PurdueROV-Archive/Cerulean-Microboard/readme.MD

This is an example repository of the previous Microboard for the ROV.

The Microboard was the brains of the ROV.
