PurdueROV-Archive/Cerulean-Microboard/MicroBoardMk2/revision.md

# pending

# applied

# not needed

# notes
Pick different buttons, as they dont fits on pads right
Check if BOOT1 needs to be pulled to GND for usb DFU
Make silkscreen larger (at least 0.4)
Remove Diode on 5V line
Figure out how to switch the 5V rail along with the +3V3 Rail
Add standoff holes
Silkscreen on GRN and BLU LED's is switched. (not by the pin but by the actual LED)
