PurdueROV-Archive/Cerulean-Microboard/MicroBoardMk2/MicroBoardMk2.png

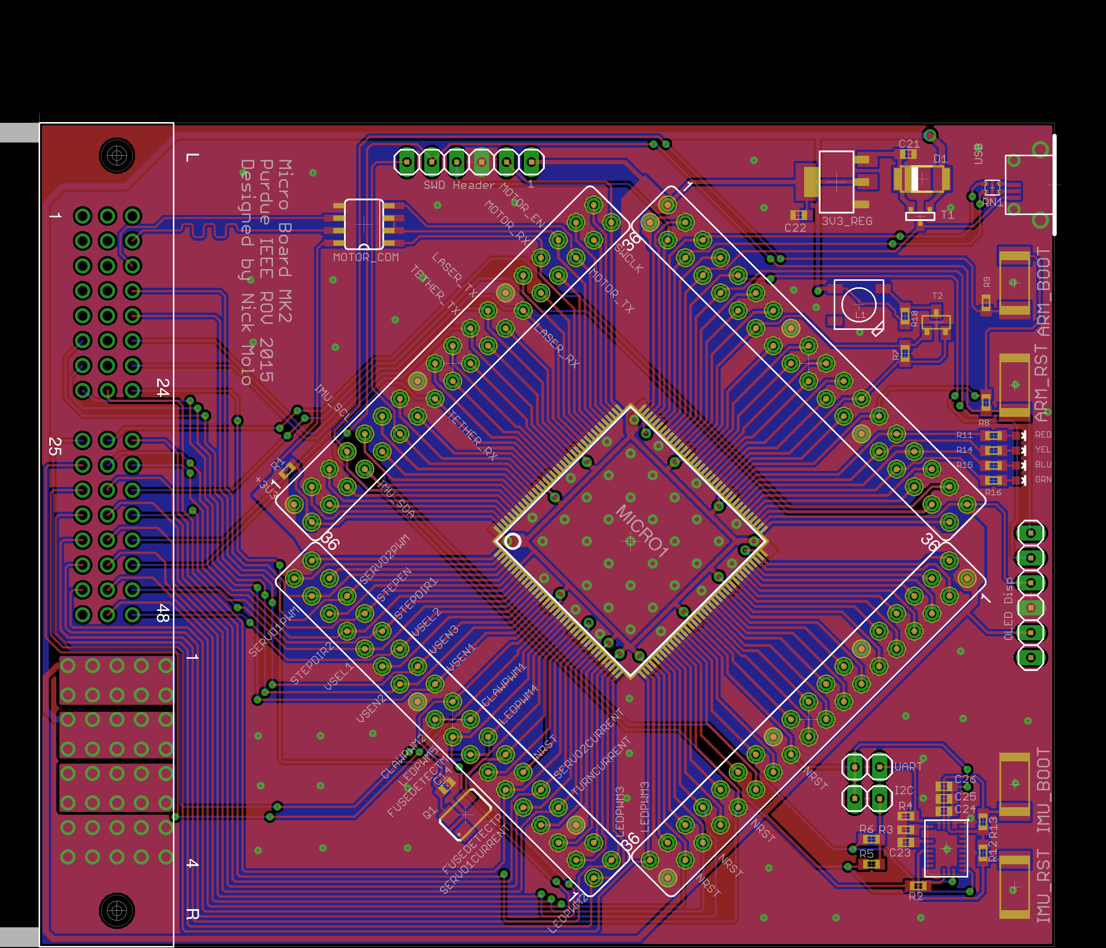
MicroBoardMk2/MicroBoardMk2.png
