PurdueROV-Archive/Cerulean-Microboard/MicroBoardMk1/MicroBoardMk1.brd

## EAGLE design MicroBoardMk1/MicroBoardMk1.brd (2015-09-24, an earlier design)

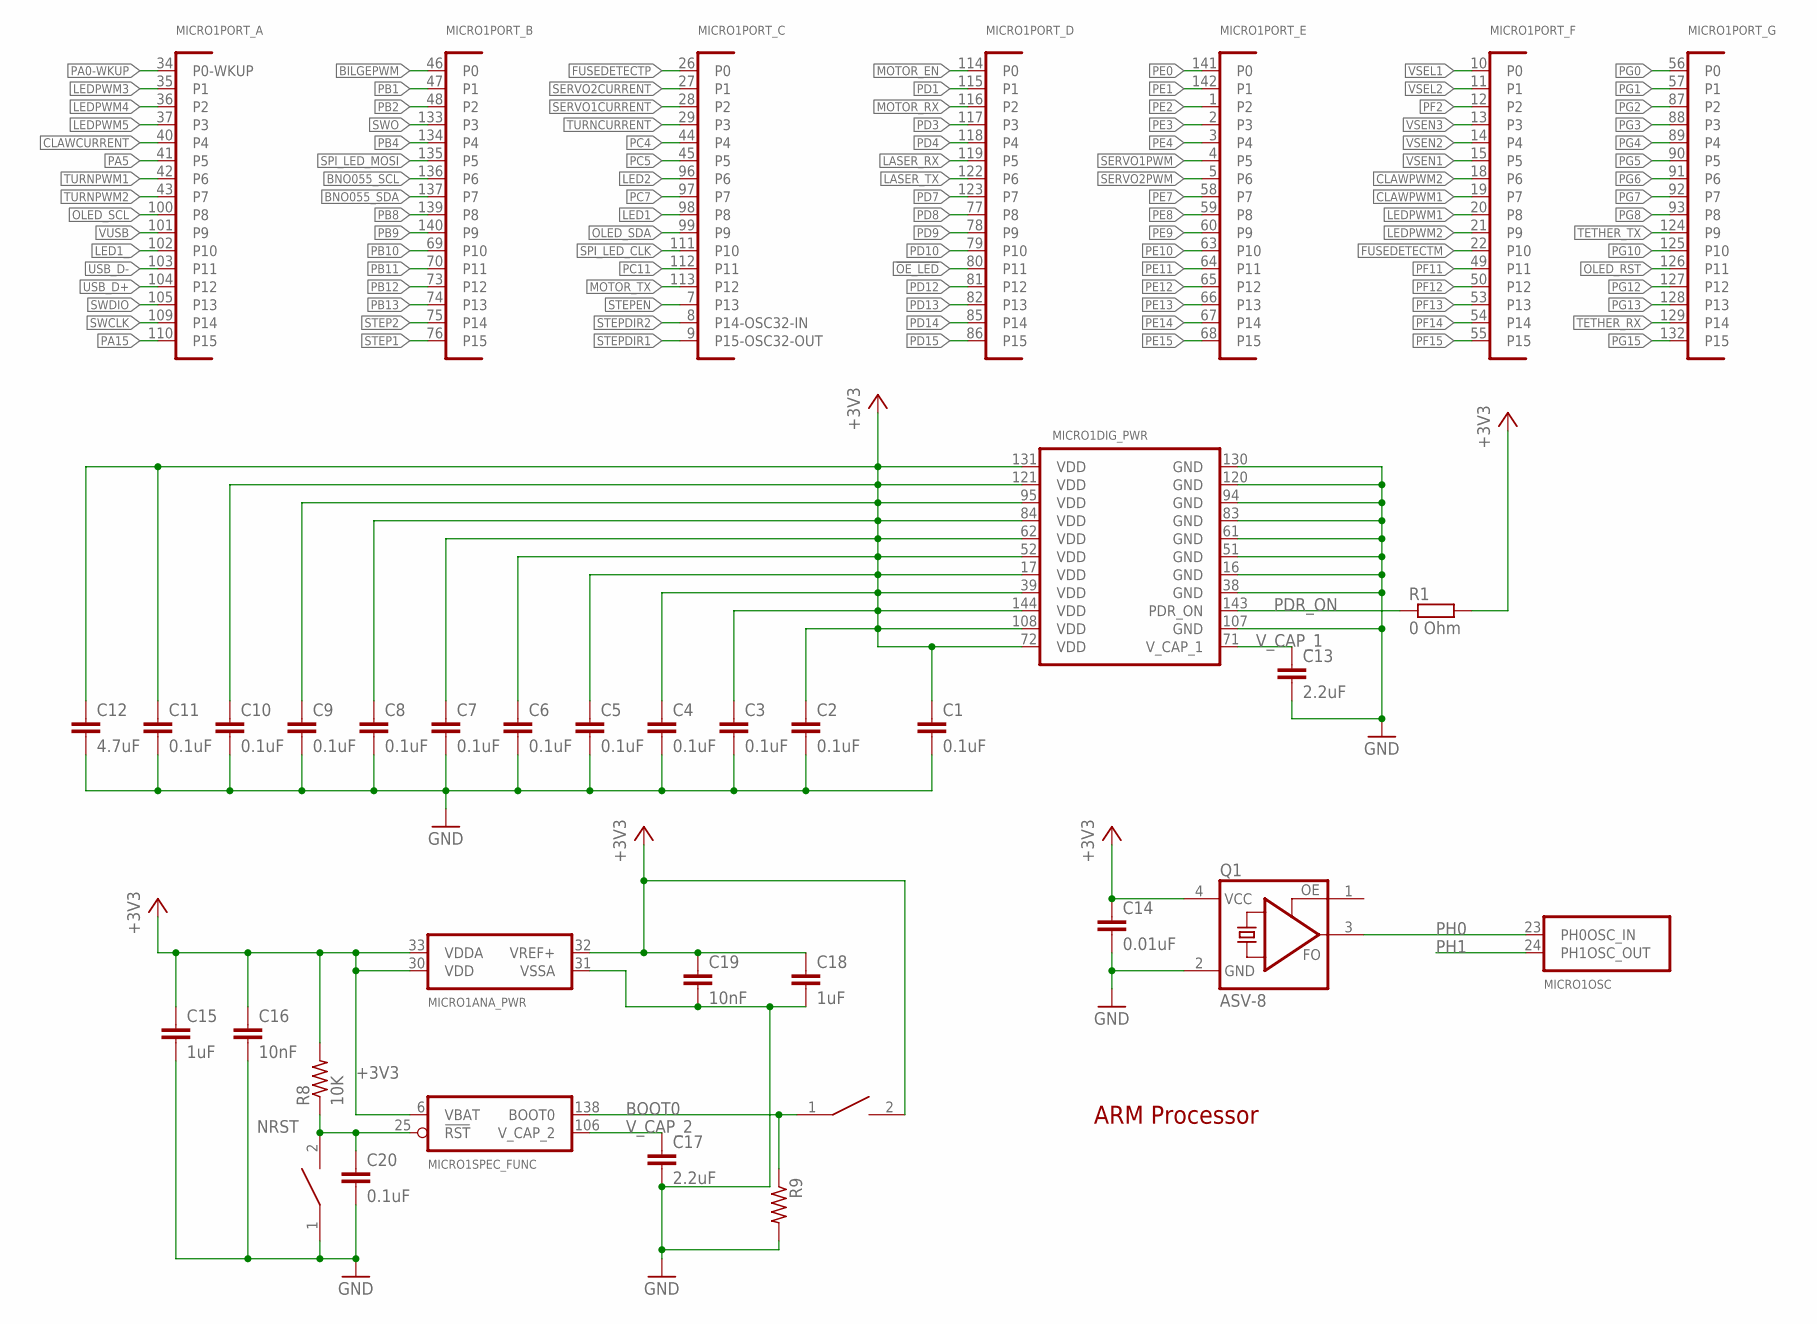
[picture p2: schematic MicroBoardMk1.sch, sheet 1]

Parts:
BOOT_SW: SWITCH; SW_2512
C1, C2, C3, C4, C5, C6, C7, C8, C9, C10, C11, C20: 0.1uF; C0603
C12: 4.7uF; C0603
C13, C17: 2.2uF; C0603
C14: 0.01uF; C0603
C15, C18: 1uF; C0603
C16, C19: 10nF; C0603
MICRO1: STM32F407ZET6; SQFP-S-20X20-144
Q1: ASV-8; ASF
R1: 0 Ohm; R0603
R8: 10K; R0603
R9: R-US_R0603; R0603
RST_SW: SWITCH; SW_2512

Connections:
!OE_LED: MICRO1.80 (P11); also elsewhere on the board
+3V3: BOOT_SW.2, C1.1, C2.1, C3.1, C4.1, C5.1, C6.1, C7.1, C8.1, C9.1, C10.1, C11.1, C12.1, C14.1, C15.1, C16.1, C18.1, C19.1, MICRO1.6 (VBAT), MICRO1.17 (VDD), MICRO1.30 (VDD), MICRO1.32 (VREF+), MICRO1.33 (VDDA), MICRO1.39 (VDD), MICRO1.52 (VDD), MICRO1.62 (VDD), MICRO1.72 (VDD), MICRO1.84 (VDD), MICRO1.95 (VDD), MICRO1.108 (VDD), MICRO1.121 (VDD), MICRO1.131 (VDD), MICRO1.144 (VDD), Q1.4 (VCC), R1.2, R8.2; also elsewhere on the board
BILGEPWM: MICRO1.46 (P0); also elsewhere on the board
BNO055_SCL: MICRO1.136 (P6); also elsewhere on the board
BNO055_SDA: MICRO1.137 (P7); also elsewhere on the board
BOOT0: BOOT_SW.1, MICRO1.138 (BOOT0), R9.1; also elsewhere on the board
CLAWCURRENT: MICRO1.40 (P4); also elsewhere on the board
CLAWPWM1: MICRO1.19 (P7); also elsewhere on the board
CLAWPWM2: MICRO1.18 (P6); also elsewhere on the board
FUSEDETECTM: MICRO1.22 (P10); also elsewhere on the board
FUSEDETECTP: MICRO1.26 (P0); also elsewhere on the board
GND: C1.2, C2.2, C3.2, C4.2, C5.2, C6.2, C7.2, C8.2, C9.2, C10.2, C11.2, C12.2, C13.2, C14.2, C15.2, C16.2, C17.2, C18.2, C19.2, C20.2, MICRO1.16 (GND), MICRO1.31 (VSSA), MICRO1.38 (GND), MICRO1.51 (GND), MICRO1.61 (GND), MICRO1.83 (GND), MICRO1.94 (GND), MICRO1.107 (GND), MICRO1.120 (GND), MICRO1.130 (GND), Q1.2 (GND), R9.2, RST_SW.1; also elsewhere on the board
LASER_RX: MICRO1.119 (P5); also elsewhere on the board
LASER_TX: MICRO1.122 (P6); also elsewhere on the board
LED1: MICRO1.98 (P8); also elsewhere on the board
LED1_: MICRO1.102 (P10); also elsewhere on the board
LED2: MICRO1.96 (P6); also elsewhere on the board
LEDPWM1: MICRO1.20 (P8); also elsewhere on the board
LEDPWM2: MICRO1.21 (P9); also elsewhere on the board
LEDPWM3: MICRO1.35 (P1); also elsewhere on the board
LEDPWM4: MICRO1.36 (P2); also elsewhere on the board
LEDPWM5: MICRO1.37 (P3); also elsewhere on the board
MOTOR_EN: MICRO1.114 (P0); also elsewhere on the board
MOTOR_RX: MICRO1.116 (P2); also elsewhere on the board
MOTOR_TX: MICRO1.113 (P12); also elsewhere on the board
NRST: C20.1, MICRO1.25 (!RST), R8.1, RST_SW.2; also elsewhere on the board
OLED_RST: MICRO1.126 (P11); also elsewhere on the board
OLED_SCL: MICRO1.100 (P8); also elsewhere on the board
OLED_SDA: MICRO1.99 (P9); also elsewhere on the board
PA0-WKUP: MICRO1.34 (P0-WKUP); also elsewhere on the board
PA5: MICRO1.41 (P5); also elsewhere on the board
PA15: MICRO1.110 (P15); also elsewhere on the board
PB1: MICRO1.47 (P1); also elsewhere on the board
PB2: MICRO1.48 (P2); also elsewhere on the board
PB4: MICRO1.134 (P4); also elsewhere on the board
PB8: MICRO1.139 (P8); also elsewhere on the board
PB9: MICRO1.140 (P9); also elsewhere on the board
PB10: MICRO1.69 (P10); also elsewhere on the board
PB11: MICRO1.70 (P11); also elsewhere on the board
PB12: MICRO1.73 (P12); also elsewhere on the board
PB13: MICRO1.74 (P13); also elsewhere on the board
PC4: MICRO1.44 (P4); also elsewhere on the board
PC5: MICRO1.45 (P5); also elsewhere on the board
PC7: MICRO1.97 (P7); also elsewhere on the board
PC11: MICRO1.112 (P11); also elsewhere on the board
PD1: MICRO1.115 (P1); also elsewhere on the board
PD3: MICRO1.117 (P3); also elsewhere on the board
PD4: MICRO1.118 (P4); also elsewhere on the board
PD7: MICRO1.123 (P7); also elsewhere on the board
PD8: MICRO1.77 (P8); also elsewhere on the board
PD9: MICRO1.78 (P9); also elsewhere on the board
PD10: MICRO1.79 (P10); also elsewhere on the board
PD12: MICRO1.81 (P12); also elsewhere on the board
PD13: MICRO1.82 (P13); also elsewhere on the board
PD14: MICRO1.85 (P14); also elsewhere on the board
PD15: MICRO1.86 (P15); also elsewhere on the board
PDR_ON: MICRO1.143 (PDR_ON), R1.1; also elsewhere on the board
PE0: MICRO1.141 (P0); also elsewhere on the board
PE1: MICRO1.142 (P1); also elsewhere on the board
PE2: MICRO1.1 (P2); also elsewhere on the board
PE3: MICRO1.2 (P3); also elsewhere on the board
PE4: MICRO1.3 (P4); also elsewhere on the board
PE7: MICRO1.58 (P7); also elsewhere on the board
PE8: MICRO1.59 (P8); also elsewhere on the board
PE9: MICRO1.60 (P9); also elsewhere on the board
PE10: MICRO1.63 (P10); also elsewhere on the board
PE11: MICRO1.64 (P11); also elsewhere on the board
PE12: MICRO1.65 (P12); also elsewhere on the board
PE13: MICRO1.66 (P13); also elsewhere on the board
PE14: MICRO1.67 (P14); also elsewhere on the board
PE15: MICRO1.68 (P15); also elsewhere on the board
PF2: MICRO1.12 (P2); also elsewhere on the board
PF11: MICRO1.49 (P11); also elsewhere on the board
PF12: MICRO1.50 (P12); also elsewhere on the board
PF13: MICRO1.53 (P13); also elsewhere on the board
PF14: MICRO1.54 (P14); also elsewhere on the board
PF15: MICRO1.55 (P15); also elsewhere on the board
PG0: MICRO1.56 (P0); also elsewhere on the board
PG1: MICRO1.57 (P1); also elsewhere on the board
PG2: MICRO1.87 (P2); also elsewhere on the board
PG3: MICRO1.88 (P3); also elsewhere on the board
PG4: MICRO1.89 (P4); also elsewhere on the board
PG5: MICRO1.90 (P5); also elsewhere on the board
PG6: MICRO1.91 (P6); also elsewhere on the board
PG7: MICRO1.92 (P7); also elsewhere on the board
PG8: MICRO1.93 (P8); also elsewhere on the board
PG10: MICRO1.125 (P10); also elsewhere on the board
PG12: MICRO1.127 (P12); also elsewhere on the board
PG13: MICRO1.128 (P13); also elsewhere on the board
PG15: MICRO1.132 (P15); also elsewhere on the board
PH0: MICRO1.23 (PH0OSC_IN), Q1.3 (FO); also elsewhere on the board
PH1: MICRO1.24 (PH1OSC_OUT); also elsewhere on the board
SERVO1CURRENT: MICRO1.28 (P2); also elsewhere on the board
SERVO1PWM: MICRO1.4 (P5); also elsewhere on the board
SERVO2CURRENT: MICRO1.27 (P1); also elsewhere on the board
SERVO2PWM: MICRO1.5 (P6); also elsewhere on the board
SPI_LED_CLK: MICRO1.111 (P10); also elsewhere on the board
SPI_LED_MOSI: MICRO1.135 (P5); also elsewhere on the board
STEP1: MICRO1.76 (P15); also elsewhere on the board
STEP2: MICRO1.75 (P14); also elsewhere on the board
STEPDIR1: MICRO1.9 (P15-OSC32-OUT); also elsewhere on the board
STEPDIR2: MICRO1.8 (P14-OSC32-IN); also elsewhere on the board
STEPEN: MICRO1.7 (P13); also elsewhere on the board
SWCLK: MICRO1.109 (P14); also elsewhere on the board
SWDIO: MICRO1.105 (P13); also elsewhere on the board
SWO: MICRO1.133 (P3); also elsewhere on the board
TETHER_RX: MICRO1.129 (P14); also elsewhere on the board
TETHER_TX: MICRO1.124 (P9); also elsewhere on the board
TURNCURRENT: MICRO1.29 (P3); also elsewhere on the board
TURNPWM1: MICRO1.42 (P6); also elsewhere on the board
TURNPWM2: MICRO1.43 (P7); also elsewhere on the board
USB_D+: MICRO1.104 (P12); also elsewhere on the board
USB_D-: MICRO1.103 (P11); also elsewhere on the board
VSEL1: MICRO1.10 (P0); also elsewhere on the board
VSEL2: MICRO1.11 (P1); also elsewhere on the board
VSEN1: MICRO1.15 (P5); also elsewhere on the board
VSEN2: MICRO1.14 (P4); also elsewhere on the board
VSEN3: MICRO1.13 (P3); also elsewhere on the board
VUSB: MICRO1.101 (P9); also elsewhere on the board
V_CAP_1: C13.1, MICRO1.71 (V_CAP_1); also elsewhere on the board
V_CAP_2: C17.1, MICRO1.106 (V_CAP_2); also elsewhere on the board

Notes on the sheet:
ARM Processor

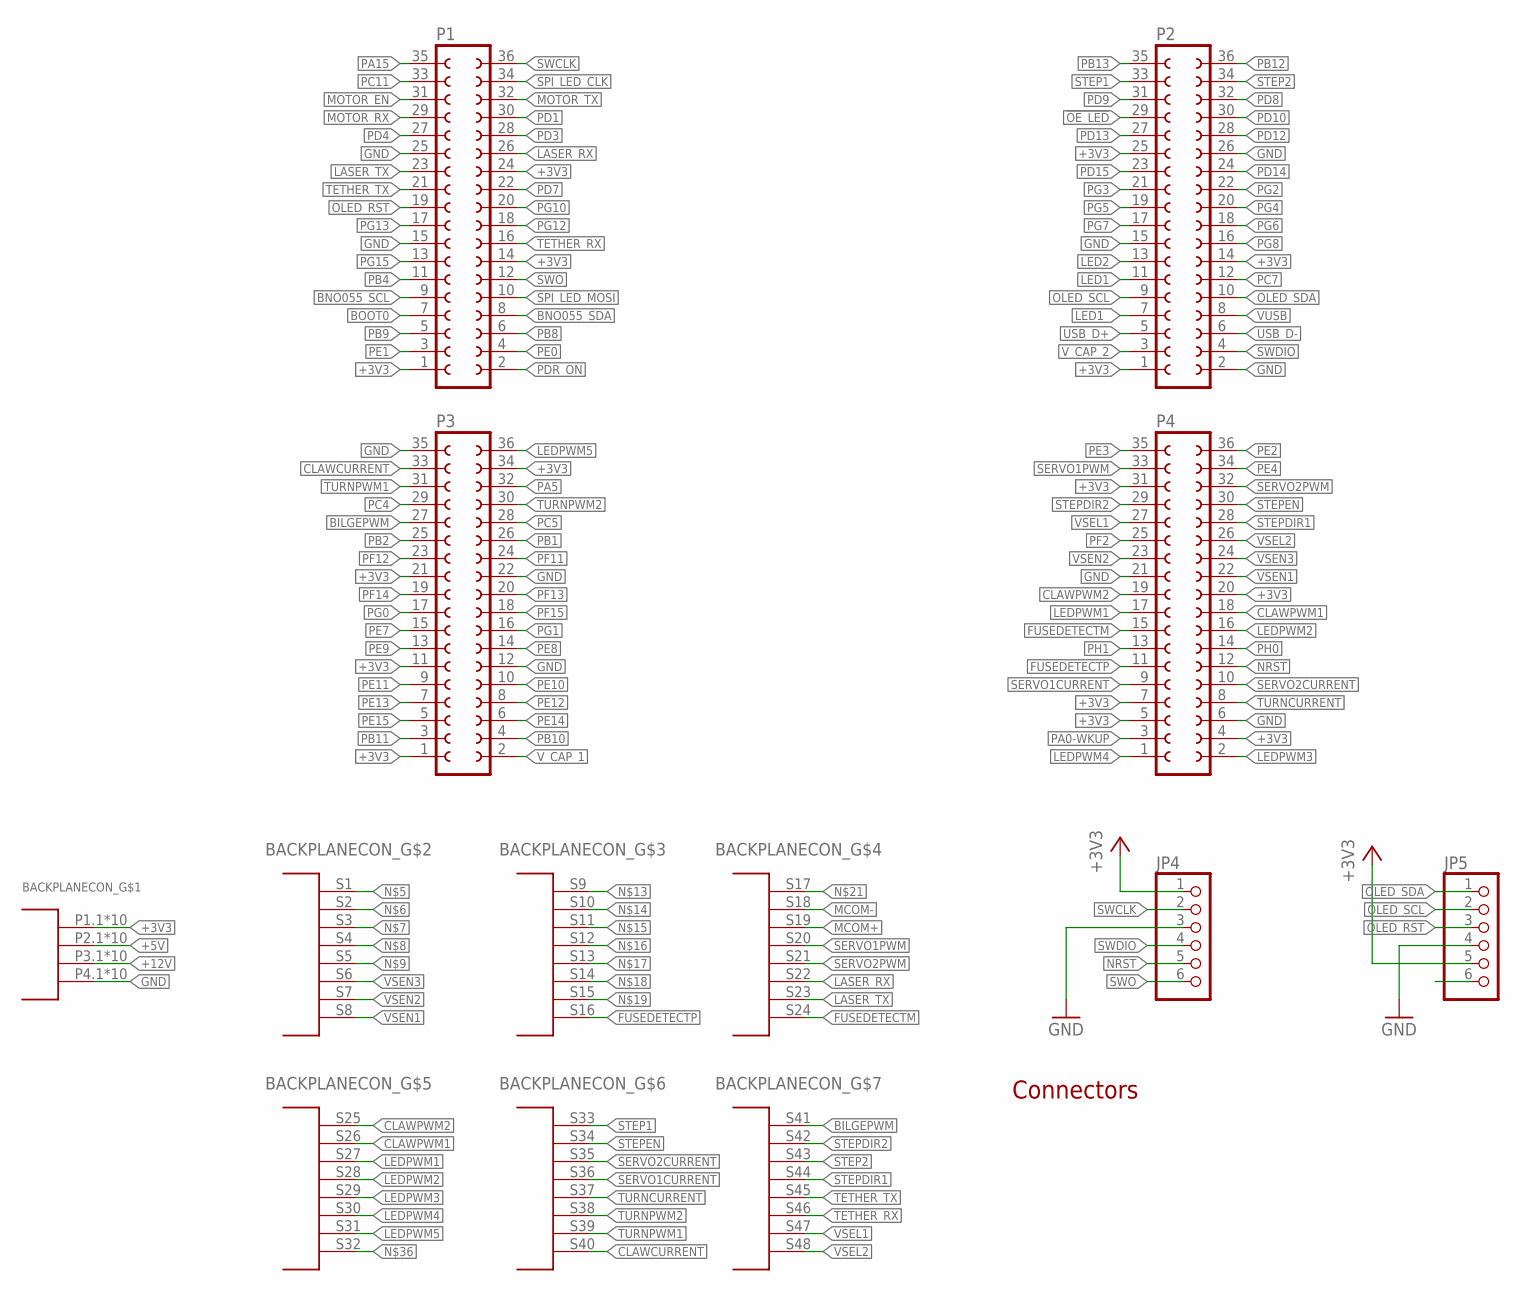
[picture p3: schematic MicroBoardMk1.sch, sheet 2]

Parts:
BACKPLANECON_: TEN60-S24-S24-P4-RA
JP4, JP5: PINHD-1X6; 1X06
P1, P2, P3, P4: FE18-2

Connections:
!OE_LED: P2.29; also elsewhere on the board
+3V3: BACKPLANECON_.P1.1, BACKPLANECON_.P1.2, BACKPLANECON_.P1.3, BACKPLANECON_.P1.4, BACKPLANECON_.P1.5, BACKPLANECON_.P1.6, BACKPLANECON_.P1.7, BACKPLANECON_.P1.8, BACKPLANECON_.P1.9, BACKPLANECON_.P1.10, JP4.1, JP5.5, P1.1, P1.14, P1.24, P2.1, P2.14, P2.25, P3.1, P3.11, P3.21, P3.34, P4.4, P4.5, P4.7, P4.20, P4.31; also elsewhere on the board
+5V: BACKPLANECON_.P2.1, BACKPLANECON_.P2.2, BACKPLANECON_.P2.3, BACKPLANECON_.P2.4, BACKPLANECON_.P2.5, BACKPLANECON_.P2.6, BACKPLANECON_.P2.7, BACKPLANECON_.P2.8, BACKPLANECON_.P2.9, BACKPLANECON_.P2.10; also elsewhere on the board
+12V: BACKPLANECON_.P3.1, BACKPLANECON_.P3.2, BACKPLANECON_.P3.3, BACKPLANECON_.P3.4, BACKPLANECON_.P3.5, BACKPLANECON_.P3.6, BACKPLANECON_.P3.7, BACKPLANECON_.P3.8, BACKPLANECON_.P3.9, BACKPLANECON_.P3.10
BILGEPWM: BACKPLANECON_.S41, P3.27; also elsewhere on the board
BNO055_SCL: P1.9; also elsewhere on the board
BNO055_SDA: P1.8; also elsewhere on the board
BOOT0: P1.7; also elsewhere on the board
CLAWCURRENT: BACKPLANECON_.S40, P3.33; also elsewhere on the board
CLAWPWM1: BACKPLANECON_.S26, P4.18; also elsewhere on the board
CLAWPWM2: BACKPLANECON_.S25, P4.19; also elsewhere on the board
FUSEDETECTM: BACKPLANECON_.S24, P4.15; also elsewhere on the board
FUSEDETECTP: BACKPLANECON_.S16, P4.11; also elsewhere on the board
GND: BACKPLANECON_.P4.1, BACKPLANECON_.P4.2, BACKPLANECON_.P4.3, BACKPLANECON_.P4.4, BACKPLANECON_.P4.5, BACKPLANECON_.P4.6, BACKPLANECON_.P4.7, BACKPLANECON_.P4.8, BACKPLANECON_.P4.9, BACKPLANECON_.P4.10, JP4.3, JP5.4, P1.15, P1.25, P2.2, P2.15, P2.26, P3.12, P3.22, P3.35, P4.6, P4.21; also elsewhere on the board
LASER_RX: BACKPLANECON_.S22, P1.26; also elsewhere on the board
LASER_TX: BACKPLANECON_.S23, P1.23; also elsewhere on the board
LED1: P2.11; also elsewhere on the board
LED1_: P2.7; also elsewhere on the board
LED2: P2.13; also elsewhere on the board
LEDPWM1: BACKPLANECON_.S27, P4.17; also elsewhere on the board
LEDPWM2: BACKPLANECON_.S28, P4.16; also elsewhere on the board
LEDPWM3: BACKPLANECON_.S29, P4.2; also elsewhere on the board
LEDPWM4: BACKPLANECON_.S30, P4.1; also elsewhere on the board
LEDPWM5: BACKPLANECON_.S31, P3.36; also elsewhere on the board
MCOM+: BACKPLANECON_.S19; also elsewhere on the board
MCOM-: BACKPLANECON_.S18; also elsewhere on the board
MOTOR_EN: P1.31; also elsewhere on the board
MOTOR_RX: P1.29; also elsewhere on the board
MOTOR_TX: P1.32; also elsewhere on the board
NRST: JP4.5, P4.12; also elsewhere on the board
OLED_RST: JP5.3, P1.19; also elsewhere on the board
OLED_SCL: JP5.2, P2.9; also elsewhere on the board
OLED_SDA: JP5.1, P2.10; also elsewhere on the board
PA0-WKUP: P4.3; also elsewhere on the board
PA5: P3.32; also elsewhere on the board
PA15: P1.35; also elsewhere on the board
PB1: P3.26; also elsewhere on the board
PB2: P3.25; also elsewhere on the board
PB4: P1.11; also elsewhere on the board
PB8: P1.6; also elsewhere on the board
PB9: P1.5; also elsewhere on the board
PB10: P3.4; also elsewhere on the board
PB11: P3.3; also elsewhere on the board
PB12: P2.36; also elsewhere on the board
PB13: P2.35; also elsewhere on the board
PC4: P3.29; also elsewhere on the board
PC5: P3.28; also elsewhere on the board
PC7: P2.12; also elsewhere on the board
PC11: P1.33; also elsewhere on the board
PD1: P1.30; also elsewhere on the board
PD3: P1.28; also elsewhere on the board
PD4: P1.27; also elsewhere on the board
PD7: P1.22; also elsewhere on the board
PD8: P2.32; also elsewhere on the board
PD9: P2.31; also elsewhere on the board
PD10: P2.30; also elsewhere on the board
PD12: P2.28; also elsewhere on the board
PD13: P2.27; also elsewhere on the board
PD14: P2.24; also elsewhere on the board
PD15: P2.23; also elsewhere on the board
PDR_ON: P1.2; also elsewhere on the board
PE0: P1.4; also elsewhere on the board
PE1: P1.3; also elsewhere on the board
PE2: P4.36; also elsewhere on the board
PE3: P4.35; also elsewhere on the board
PE4: P4.34; also elsewhere on the board
PE7: P3.15; also elsewhere on the board
PE8: P3.14; also elsewhere on the board
PE9: P3.13; also elsewhere on the board
PE10: P3.10; also elsewhere on the board
PE11: P3.9; also elsewhere on the board
PE12: P3.8; also elsewhere on the board
PE13: P3.7; also elsewhere on the board
PE14: P3.6; also elsewhere on the board
PE15: P3.5; also elsewhere on the board
PF2: P4.25; also elsewhere on the board
PF11: P3.24; also elsewhere on the board
PF12: P3.23; also elsewhere on the board
PF13: P3.20; also elsewhere on the board
PF14: P3.19; also elsewhere on the board
PF15: P3.18; also elsewhere on the board
PG0: P3.17; also elsewhere on the board
PG1: P3.16; also elsewhere on the board
PG2: P2.22; also elsewhere on the board
PG3: P2.21; also elsewhere on the board
PG4: P2.20; also elsewhere on the board
PG5: P2.19; also elsewhere on the board
PG6: P2.18; also elsewhere on the board
PG7: P2.17; also elsewhere on the board
PG8: P2.16; also elsewhere on the board
PG10: P1.20; also elsewhere on the board
PG12: P1.18; also elsewhere on the board
PG13: P1.17; also elsewhere on the board
PG15: P1.13; also elsewhere on the board
PH0: P4.14; also elsewhere on the board
PH1: P4.13; also elsewhere on the board
SERVO1CURRENT: BACKPLANECON_.S36, P4.9; also elsewhere on the board
SERVO1PWM: BACKPLANECON_.S20, P4.33; also elsewhere on the board
SERVO2CURRENT: BACKPLANECON_.S35, P4.10; also elsewhere on the board
SERVO2PWM: BACKPLANECON_.S21, P4.32; also elsewhere on the board
SPI_LED_CLK: P1.34; also elsewhere on the board
SPI_LED_MOSI: P1.10; also elsewhere on the board
STEP1: BACKPLANECON_.S33, P2.33; also elsewhere on the board
STEP2: BACKPLANECON_.S43, P2.34; also elsewhere on the board
STEPDIR1: BACKPLANECON_.S44, P4.28; also elsewhere on the board
STEPDIR2: BACKPLANECON_.S42, P4.29; also elsewhere on the board
STEPEN: BACKPLANECON_.S34, P4.30; also elsewhere on the board
SWCLK: JP4.2, P1.36; also elsewhere on the board
SWDIO: JP4.4, P2.4; also elsewhere on the board
SWO: JP4.6, P1.12; also elsewhere on the board
TETHER_RX: BACKPLANECON_.S46, P1.16; also elsewhere on the board
TETHER_TX: BACKPLANECON_.S45, P1.21; also elsewhere on the board
TURNCURRENT: BACKPLANECON_.S37, P4.8; also elsewhere on the board
TURNPWM1: BACKPLANECON_.S39, P3.31; also elsewhere on the board
TURNPWM2: BACKPLANECON_.S38, P3.30; also elsewhere on the board
USB_D+: P2.5; also elsewhere on the board
USB_D-: P2.6; also elsewhere on the board
VSEL1: BACKPLANECON_.S47, P4.27; also elsewhere on the board
VSEL2: BACKPLANECON_.S48, P4.26; also elsewhere on the board
VSEN1: BACKPLANECON_.S8, P4.22; also elsewhere on the board
VSEN2: BACKPLANECON_.S7, P4.23; also elsewhere on the board
VSEN3: BACKPLANECON_.S6, P4.24; also elsewhere on the board
VUSB: P2.8; also elsewhere on the board
V_CAP_1: P3.2; also elsewhere on the board
V_CAP_2: P2.3; also elsewhere on the board

Notes on the sheet:
Connectors

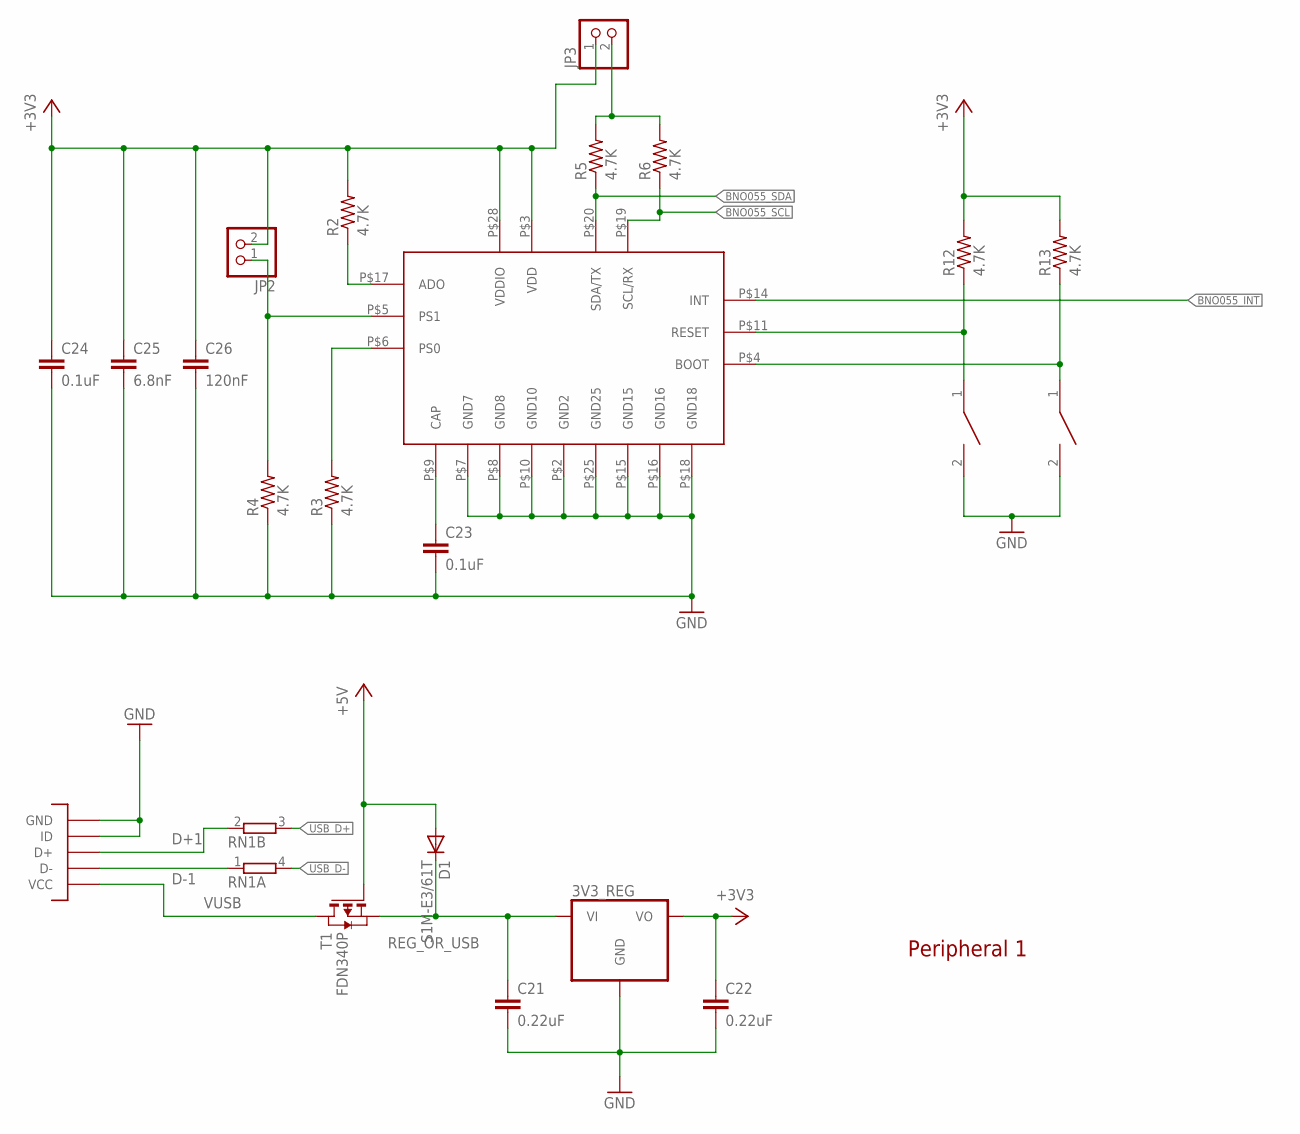
[picture p4: schematic MicroBoardMk1.sch, sheet 3]

Parts:
3V3_REG: AP1117-3.3SOT223; SOT223
BNO055: BNO055; LGA28
BNO_BOOT_SW: SWITCH; SW_2512
BNO_RST_SW: SWITCH; SW_2512
C21, C22: 0.22uF; C0603
C23, C24: 0.1uF; C0603
C25: 6.8nF; C0603
C26: 120nF; C0603
D1: S1M-E3/61T; DO-214AC
JP1: MICROUSB; MICRO_B
JP2, JP3: PINHD-1X2; 1X02
R2, R3, R4, R5, R6, R12, R13: 4.7K; R0603
RN1: 2R-NEXBV4V; EXBV4V
T1: FDN340P; SOT-23

Connections:
+3V3: 3V3_REG.2 (VO), 3V3_REG.4 (VO), BNO055.P$3 (VDD), BNO055.P$28 (VDDIO), C22.1, C24.1, C25.1, C26.1, JP2.2, JP3.1, R2.2, R12.2, R13.2; also elsewhere on the board
+5V: D1.A, T1.3 (G); also elsewhere on the board
BNO055_INT: BNO055.P$14 (INT)
BNO055_SCL: BNO055.P$19 (SCL/RX), R6.1; also elsewhere on the board
BNO055_SDA: BNO055.P$20 (SDA/TX), R5.1; also elsewhere on the board
D+1: JP1.P3 (D+), RN1.2 (1)
D-1: JP1.P2 (D-), RN1.1
GND: 3V3_REG.1 (GND), BNO055.P$2 (GND2), BNO055.P$7 (GND7), BNO055.P$8 (GND8), BNO055.P$10 (GND10), BNO055.P$15 (GND15), BNO055.P$16 (GND16), BNO055.P$18 (GND18), BNO055.P$25 (GND25), BNO_BOOT_SW.2, BNO_RST_SW.2, C21.2, C22.2, C23.2, C24.2, C25.2, C26.2, JP1.GND1 (GND), JP1.GND2 (GND), JP1.GND3 (GND), JP1.GND4 (GND), JP1.GND7 (GND), JP1.GND8 (GND), JP1.P4 (ID), JP1.P5 (GND), R3.1, R4.1; also elsewhere on the board
unnamed: BNO055.P$9 (CAP), C23.1
unnamed: BNO055.P$17 (ADO), R2.1
unnamed: BNO055.P$5 (PS1), JP2.1, R4.2
unnamed: BNO055.P$6 (PS0), R3.2
unnamed: JP3.2, R5.2, R6.2
unnamed: BNO055.P$4 (BOOT), BNO_BOOT_SW.1, R13.1
unnamed: BNO055.P$11 (RESET), BNO_RST_SW.1, R12.1
REG_OR_USB: 3V3_REG.3 (VI), C21.1, D1.C, T1.2 (S)
USB_D+: RN1.3 (2); also elsewhere on the board
USB_D-: RN1.4 (2); also elsewhere on the board
VUSB: JP1.P1 (VCC), T1.1 (D); also elsewhere on the board

Notes on the sheet:
Peripheral 1

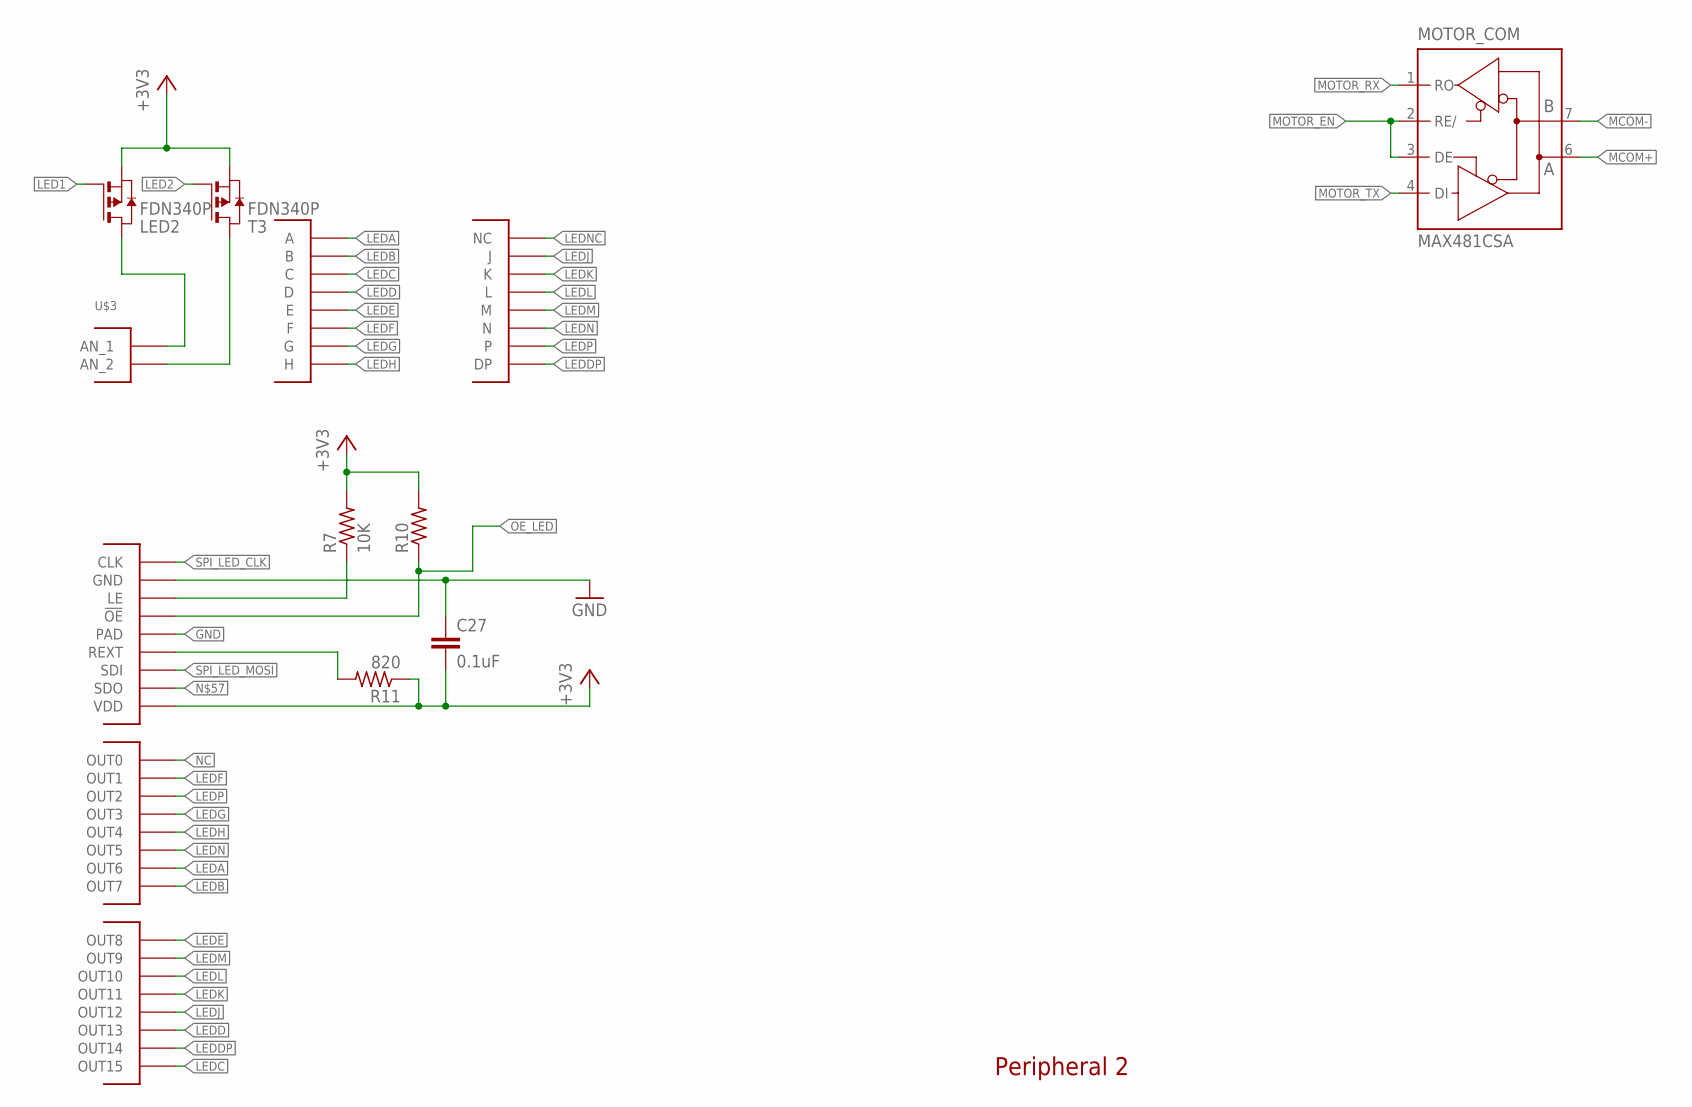
[picture p5: schematic MicroBoardMk1.sch, sheet 4]

Parts:
A6282: A6282; TSSOP24
C27: 0.1uF; C0603
LED2: FDN340P; SOT-23
MOTOR_COM: MAX481CSA; SO08
R7: 10K; R0603
R10: R-US_R0603; R0603
R11: 820; R0603
T3: FDN340P; SOT-23
U$3: LEDDISP

Connections:
!OE_LED: A6282.21 (!OE), R10.1; also elsewhere on the board
+3V3: A6282.24 (VDD), C27.2, LED2.2 (S), R7.2, R10.2, R11.1, T3.2 (S); also elsewhere on the board
GND: A6282.1 (GND), A6282.PAD, C27.1, MOTOR_COM.5 (GND); also elsewhere on the board
LED1: LED2.3 (G); also elsewhere on the board
LED2: T3.3 (G); also elsewhere on the board
LEDA: A6282.11 (OUT6), U$3.P$12 (A)
LEDB: A6282.12 (OUT7), U$3.P$10 (B)
LEDC: A6282.20 (OUT15), U$3.P$9 (C)
LEDD: A6282.18 (OUT13), U$3.P$7 (D)
LEDDP: A6282.19 (OUT14), U$3.P$8 (DP)
LEDE: A6282.13 (OUT8), U$3.P$1 (E)
LEDF: A6282.6 (OUT1), U$3.P$18 (F)
LEDG: A6282.8 (OUT3), U$3.P$15 (G)
LEDH: A6282.9 (OUT4), U$3.P$14 (H)
LEDJ: A6282.17 (OUT12), U$3.P$6 (J)
LEDK: A6282.16 (OUT11), U$3.P$5 (K)
LEDL: A6282.15 (OUT10), U$3.P$4 (L)
LEDM: A6282.14 (OUT9), U$3.P$2 (M)
LEDN: A6282.10 (OUT5), U$3.P$13 (N)
LEDNC: U$3.P$3 (NC)
LEDP: A6282.7 (OUT2), U$3.P$17
MCOM+: MOTOR_COM.6 (A); also elsewhere on the board
MCOM-: MOTOR_COM.7 (B); also elsewhere on the board
MOTOR_EN: MOTOR_COM.2 (RE/), MOTOR_COM.3 (DE); also elsewhere on the board
MOTOR_RX: MOTOR_COM.1 (RO); also elsewhere on the board
MOTOR_TX: MOTOR_COM.4 (DI); also elsewhere on the board
unnamed: T3.1 (D), U$3.P$11 (AN_2)
unnamed: LED2.1 (D), U$3.P$16 (AN_1)
unnamed: A6282.4 (LE), R7.1
unnamed: A6282.23 (REXT), R11.2
NC: A6282.5 (OUT0)
SPI_LED_CLK: A6282.3 (CLK); also elsewhere on the board
SPI_LED_MOSI: A6282.2 (SDI); also elsewhere on the board
VCC: MOTOR_COM.8 (VCC)

Notes on the sheet:
Peripheral 2

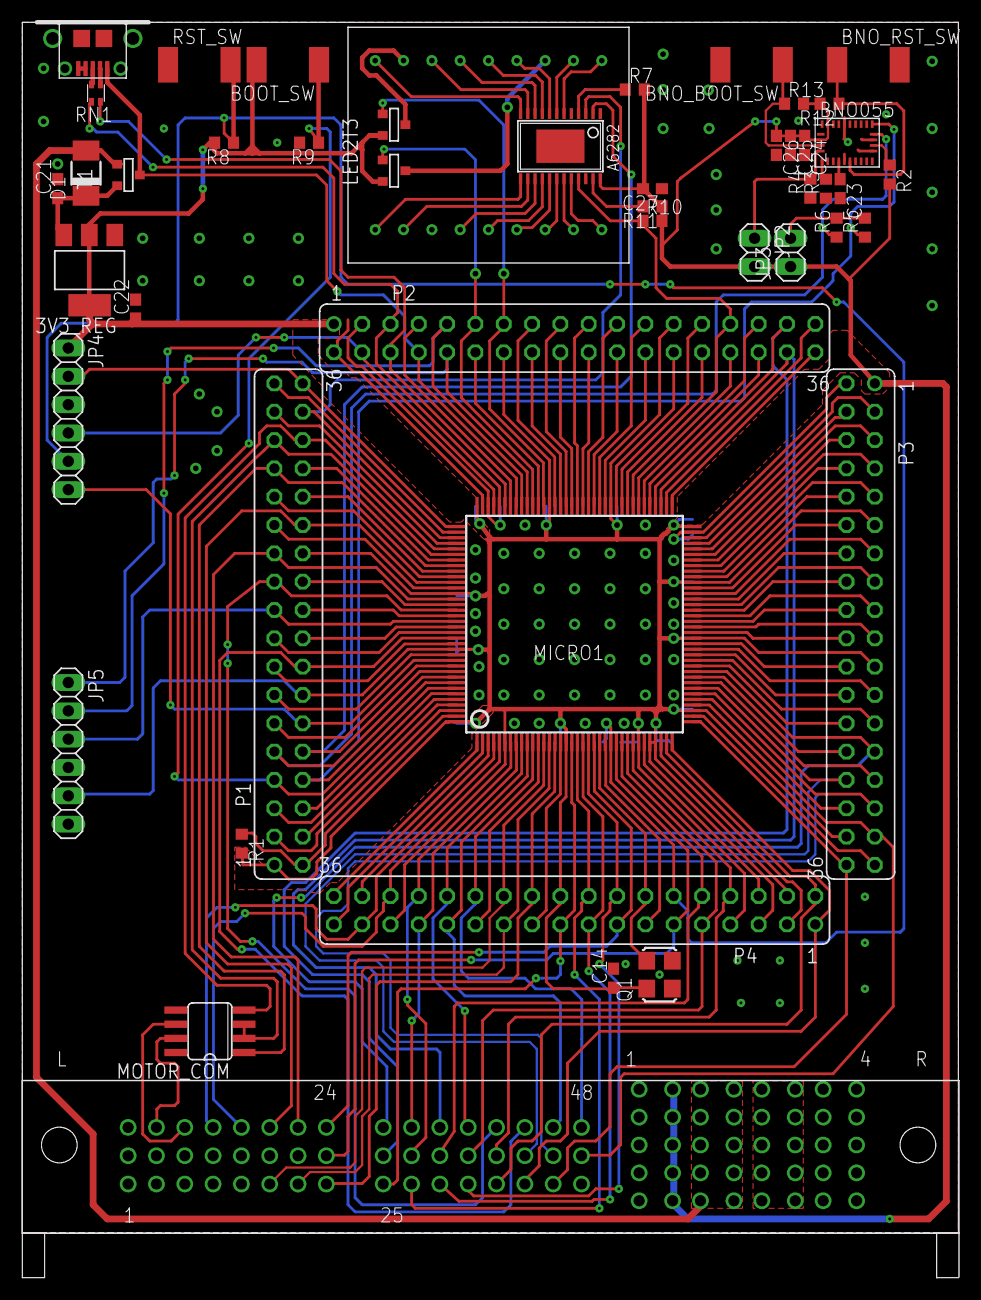
[picture p6: board MicroBoardMk1.brd from above]

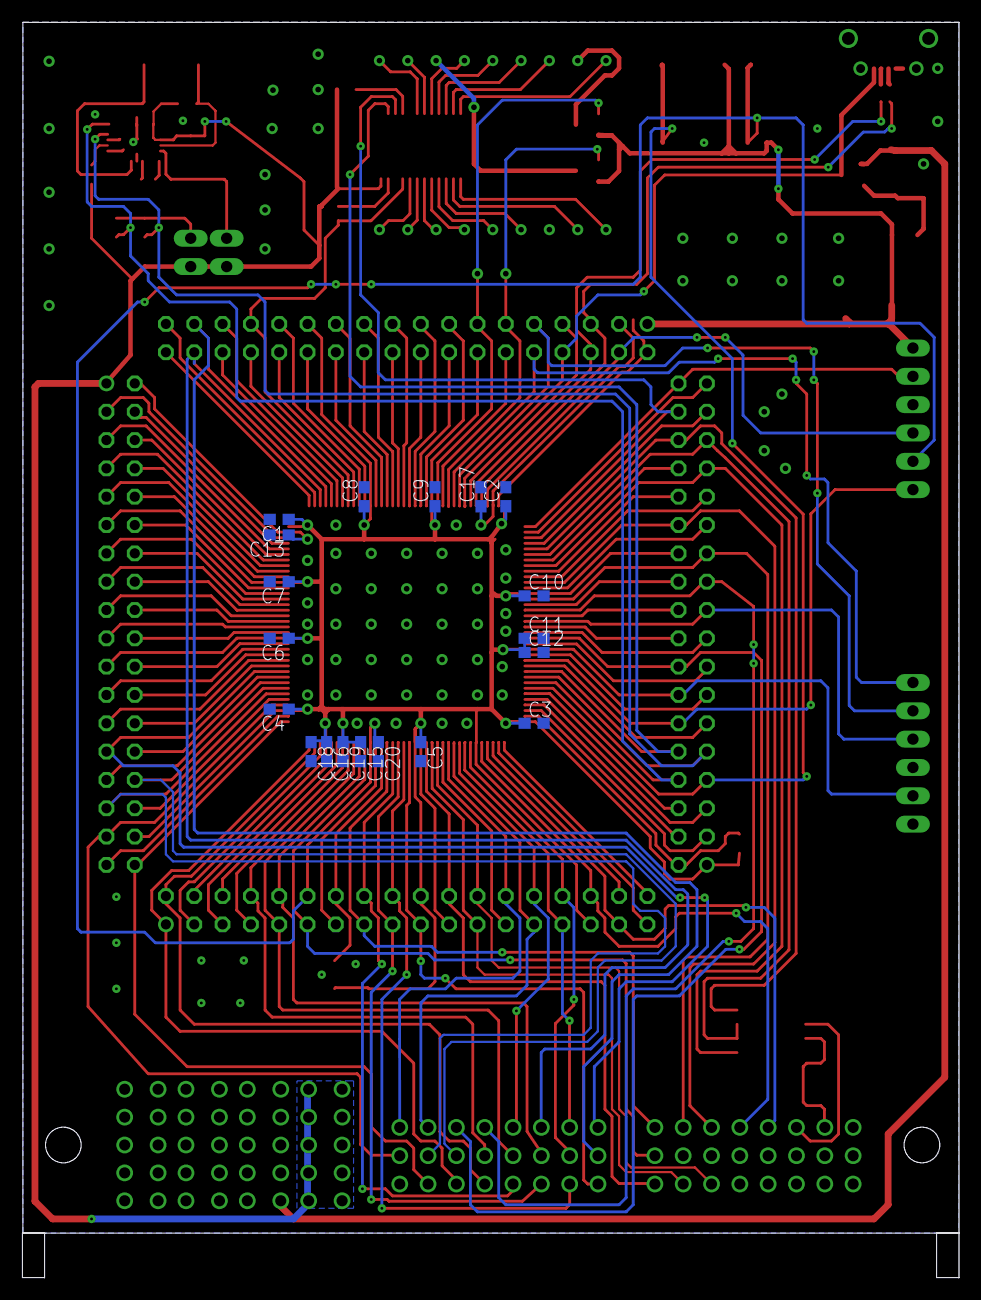
[picture p7: board MicroBoardMk1.brd from below]

Board: 2 copper layers, 84.0 x 112.6 mm, 66 parts (19 on the bottom side), 154 nets.
