PurdueROV-Archive/Cerulean-Microboard/(notices)

Notices in the files:
parts and their libraries:
SparkFun-LED: Licensing: CC v3.0 Share-Alike You are welcome to use this library for commercial purposes.
SparkFun-Connectors: Licensing: Creative Commons ShareAlike 4.0 International - https://creativecommons.org/licenses/by-sa/4.0
